yimengq/in-pipe-electronics-software/pcb/v0/PERIPH/PERIPH.xlsx

Component | Quantity | Unit Price | Total Price | Part Number (Digikey) | Notes | Link | Datasheet
TI DRV8234 Motor Driver | 3 | 4.06 | 12.18 | 296-DRV8234RTERTR-ND |  | https://www.digikey.com/en/products/detail/texas-instruments/DRV8234RTER/22147183 | https://www.ti.com/lit/ds/symlink/drv8234.pdf
MCP4725A0 DAC | 2 | 1.27 | 2.54 | MCP4725A0T-E/CHTR-ND |  | https://www.digikey.com/en/products/detail/microchip-technology/MCP4725A0T-E-CH/1818537 | https://ww1.microchip.com/downloads/aemDocuments/documents/MSLD/ProductDocuments/DataSheets/MCP4725-Data-Sheet-20002039E.pdf
MCP4725A1 DAC | 1 | 1.27 | 1.27 | MCP4725A1T-E/CHTR-ND | Specific MCP4725 part doesn't matter, as long as at least one of them has a different suffix (address reasons) | https://www.digikey.com/en/products/detail/microchip-technology/MCP4725A1T-E-CH/1827895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 | https://ww1.microchip.com/downloads/aemDocuments/documents/MSLD/ProductDocuments/DataSheets/MCP4725-Data-Sheet-20002039E.pdf
INA219 Current/Power Monitor | 1 | 2.9 | 2.9 | 296-27898-2-ND |  | https://www.digikey.com/en/products/detail/texas-instruments/INA219BIDCNT/2426056 | https://www.ti.com/lit/ds/symlink/ina219.pdf?ts=1766429459391
TI TPSM33625 Buck | 3 | 4.03 | 12.09 | 296-TPSM33625RDNRTR-ND | Estimated stock date (1-7) | https://www.digikey.com/en/products/detail/texas-instruments/TPSM33625RDNR/17395211 | https://www.ti.com/lit/ds/symlink/tpsm33625.pdf
JST SH 4 position 1 mm pitch connector | 2 | 3.95 | 7.9 | 1528-4208-ND | This might be a 10 pack (listed on Adafruit, but not sure) | https://www.digikey.com/en/products/detail/adafruit-industries-llc/4208/10230005 | https://cdn-shop.adafruit.com/product-files/4208/4208_Kaweei_C13396_diagram.pdf
