yimengq/in-pipe-electronics-software/pcb/v0/PERIPH/PERIPH.kicad_pcb

## KiCad design pcb/v0/PERIPH/PERIPH.kicad_pcb (2025-12-30)

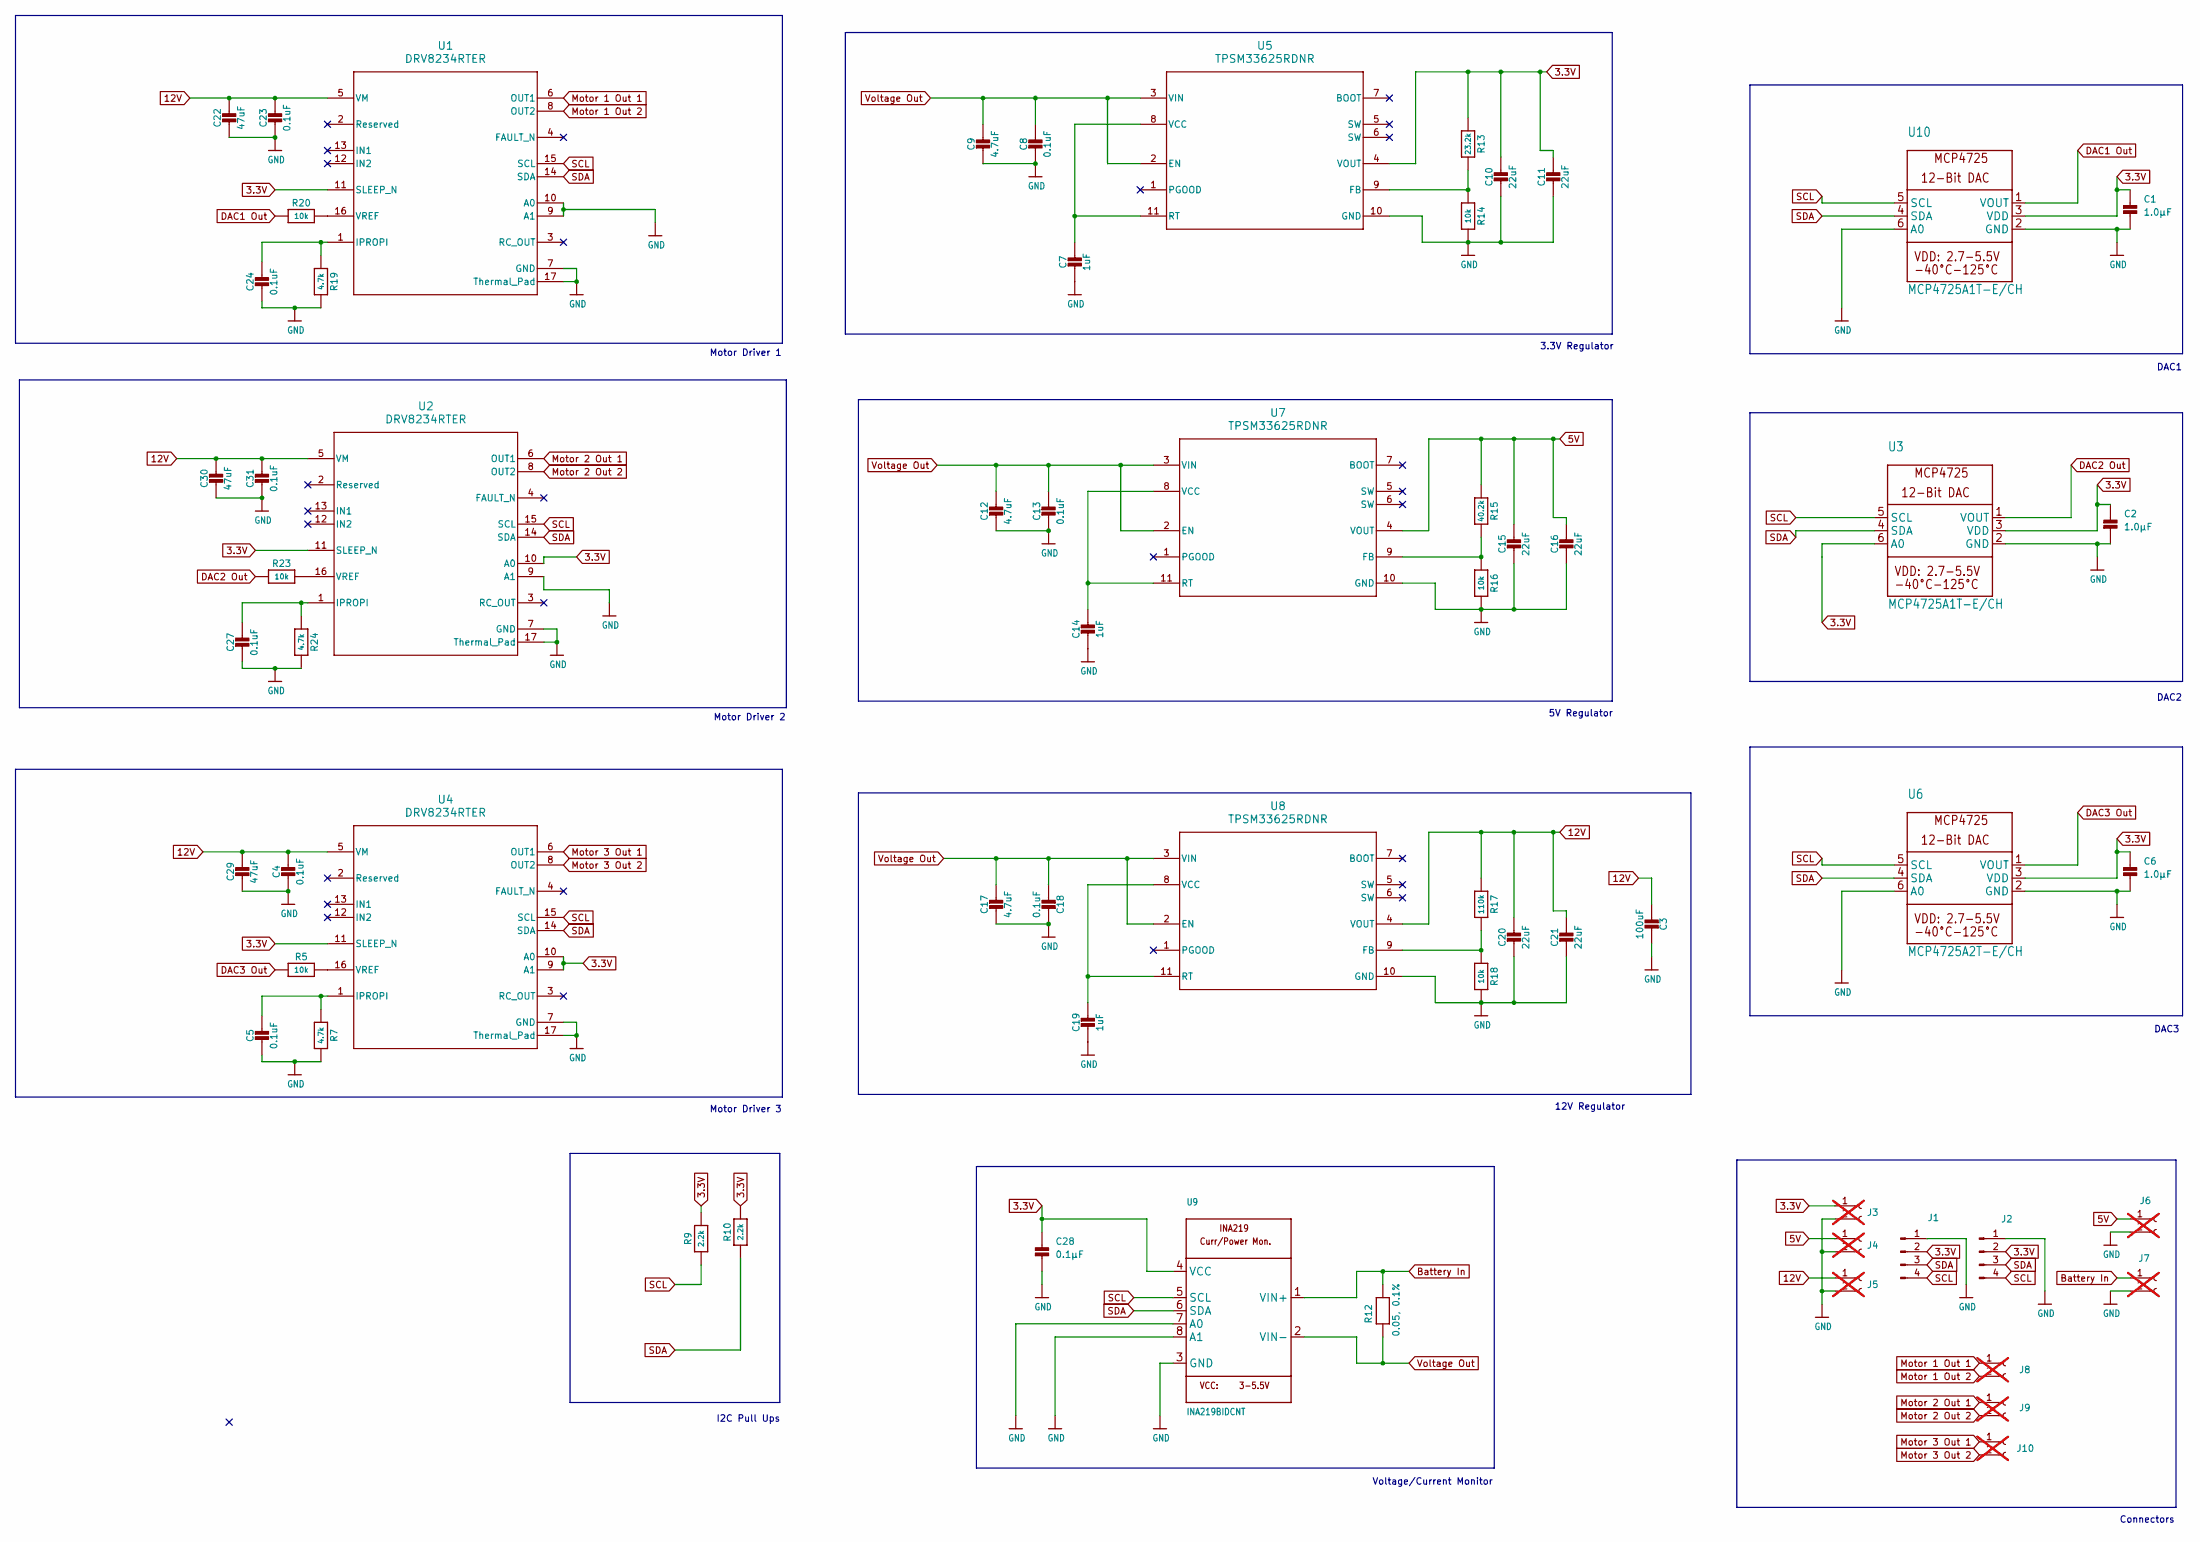
[picture p1: schematic PERIPH.kicad_sch]

Parts:
C1, C2, C6: 1.0µF; R_0603_1608Metric; MPN CL10B105KP8NNNC
C3: 100uF; PCAP_EEHZ_G_PAN-L; MPN EEH-ZA1H101P
C4, C5, C8, C13, C18, C23, C24, C27, C31: 0.1uF; R_0603_1608Metric; MPN C0603C104K3RACTU
C7, C14, C19: 1uF; R_0603_1608Metric; MPN CL10B105KP8NNNC
C9, C12, C17: 4.7uF; R_0805_2012Metric; MPN TMK212AB7475KG-T
C10, C11, C15, C16, C20, C21: 22uF; CAPC3225X270N; MPN CL32B226KAJNNNE
C22, C29, C30: 47uF; R_0603_1608Metric; MPN KTS250B476M76N0T00
C28: 0.1µF; R_0603_1608Metric; MPN C0603C104K3RACTU
J1, J2: JST SH 4 pin; CONN_SM04B-SRSS-TB_JST; MPN SM04B-SRSS-TB
J3, J4, J5, J6, J7, J8, J9, J10: Conn_01x02_Socket; PinSocket_1x02_P2.00mm_Vertical; not fitted
R5, R14, R16, R18, R20, R23: 10k; R_0603_1608Metric; MPN RC0603FR-0710KL
R7, R19, R24: 4.7k; R_0603_1608Metric; MPN CR0603-JW-472ELF
R9, R10: 2.2k; R_0603_1608Metric; MPN CR0603-FX-2201ELF
R12: 0.05, 0.1%; R_2512_6332Metric; MPN HoCG25122R050A4
R13: 23.2k; R_0603_1608Metric; MPN RC0603FR-0723K2L
R15: 40.2k; R_0603_1608Metric; MPN RC0603FR-0740K2L
R17: 110k; R_0603_1608Metric; MPN CRCW0603110KFKEAC
U1, U2, U4: DRV8234RTER; RTE0016C-IPC_A; MPN DRV8234RTER
U3, U10: MCP4725A1T-E/CH; SOT-23-6_MC_MCH; MPN MCP4725A1T-E/CH
U5, U7, U8: TPSM33625RDNR; RDN0011A-MFG; MPN TPSM33625RDNR
U6: MCP4725A2T-E/CH; SOT-23-6_MC_MCH; MPN MCP4725A2T-E/CH
U9: INA219BIDCNT; SOT65P280X145-8N; MPN INA219BIDCNT

Connections:
3.3V: C1.1, C2.1, C6.1, C10.1, C11.1, C28.1, J1.2, J2.2, J3.1, R9.2, R10.2, R13.1, U1.11 (SLEEP_N), U2.10 (A0), U2.11 (SLEEP_N), U3.3 (VDD), U3.6 (A0), U4.9 (A1), U4.10 (A0), U4.11 (SLEEP_N), U5.4 (VOUT), U6.3 (VDD), U9.4 (VCC), U10.3 (VDD)
5V: C15.1, C16.1, J4.1, J6.1, R15.1, U7.4 (VOUT)
12V: C3.1, C4.1, C20.1, C21.1, C22.1, C23.1, C29.1, C30.1, C31.1, J5.1, R17.1, U1.5 (VM), U2.5 (VM), U4.5 (VM), U8.4 (VOUT)
Battery In: J7.1, R12.2, U9.1 (VIN+)
DAC1 Out: R20.1, U10.1 (VOUT)
DAC2 Out: R23.1, U3.1 (VOUT)
DAC3 Out: R5.1, U6.1 (VOUT)
GND: C1.2, C2.2, C3.2, C4.2, C5.2, C6.2, C7.2, C8.2, C9.2, C10.2, C11.2, C12.2, C13.2, C14.2, C15.2, C16.2, C17.2, C18.2, C19.2, C20.2, C21.2, C22.2, C23.2, C24.2, C27.2, C28.2, C29.2, C30.2, C31.2, J1.1, J2.1, J3.2, J4.2, J5.2, J6.2, J7.2, R7.2, R14.2, R16.2, R18.2, R19.2, R24.2, U1.7 (GND), U1.9 (A1), U1.10 (A0), U1.17 (Thermal_Pad), U2.7 (GND), U2.9 (A1), U2.17 (Thermal_Pad), U3.2 (GND), U4.7 (GND), U4.17 (Thermal_Pad), U5.10 (GND), U6.2 (GND), U6.6 (A0), U7.10 (GND), U8.10 (GND), U9.3 (GND), U9.7 (A0), U9.8 (A1), U10.2 (GND), U10.6 (A0)
Motor 1 Out 1: J8.1, U1.6 (OUT1)
Motor 1 Out 2: J8.2, U1.8 (OUT2)
Motor 2 Out 1: J9.1, U2.6 (OUT1)
Motor 2 Out 2: J9.2, U2.8 (OUT2)
Motor 3 Out 1: J10.1, U4.6 (OUT1)
Motor 3 Out 2: J10.2, U4.8 (OUT2)
unnamed: C24.1, R19.1, U1.1 (IPROPI)
unnamed: R20.2, U1.16 (VREF)
unnamed: C27.1, R24.1, U2.1 (IPROPI)
unnamed: R23.2, U2.16 (VREF)
unnamed: C5.1, R7.1, U4.1 (IPROPI)
unnamed: R5.2, U4.16 (VREF)
unnamed: R13.2, R14.1, U5.9 (FB)
unnamed: C7.1, U5.8 (VCC), U5.11 (RT)
unnamed: R15.2, R16.1, U7.9 (FB)
unnamed: C14.1, U7.8 (VCC), U7.11 (RT)
unnamed: R17.2, R18.1, U8.9 (FB)
unnamed: C19.1, U8.8 (VCC), U8.11 (RT)
SCL: J1.4, J2.4, R9.1, U1.15 (SCL), U2.15 (SCL), U3.5 (SCL), U4.15 (SCL), U6.5 (SCL), U9.5 (SCL), U10.5 (SCL)
SDA: J1.3, J2.3, R10.1, U1.14 (SDA), U2.14 (SDA), U3.4 (SDA), U4.14 (SDA), U6.4 (SDA), U9.6 (SDA), U10.4 (SDA)
Voltage Out: C8.1, C9.1, C12.1, C13.1, C17.1, C18.1, R12.1, U5.2 (EN), U5.3 (VIN), U7.2 (EN), U7.3 (VIN), U8.2 (EN), U8.3 (VIN), U9.2 (VIN-)

Notes on the sheet:
Motor Driver 3
Motor Driver 2
I2C Pull Ups
DAC1
3.3V Regulator
Motor Driver 1
Voltage/Current Monitor
DAC2
Connectors
5V Regulator
12V Regulator
DAC3

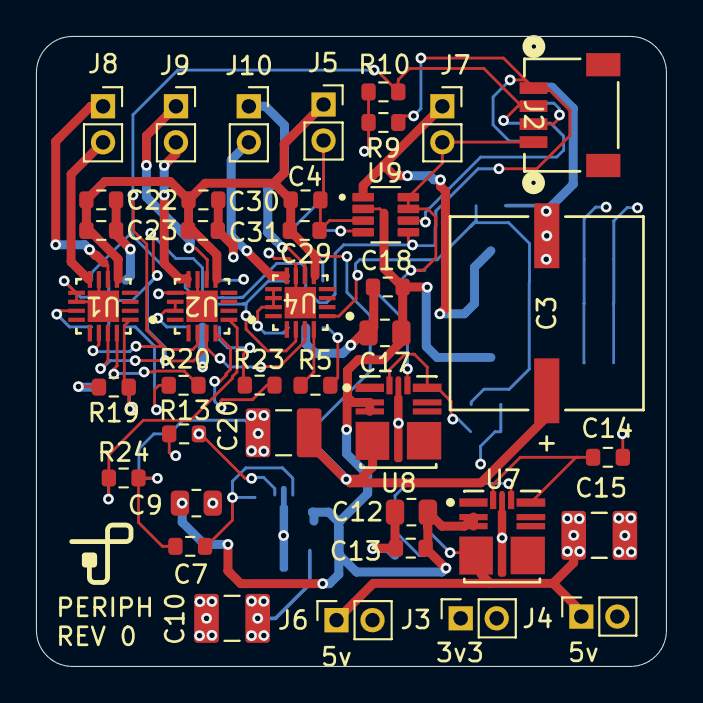
[picture p2: board PERIPH.kicad_pcb from above]

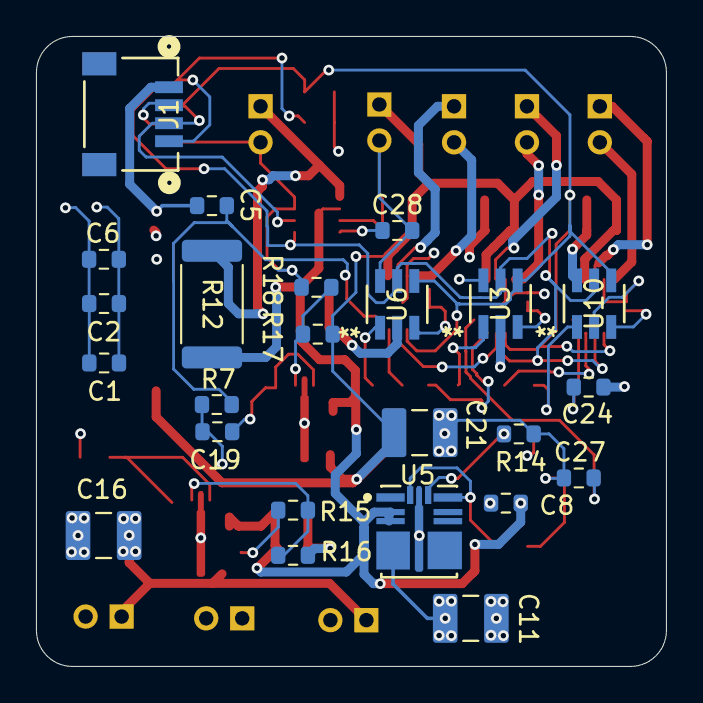
[picture p3: board PERIPH.kicad_pcb from below]

Board: 4 copper layers, 35.0 x 35.0 mm, 65 parts (24 on the bottom side), 29 nets.

Other parts of the board:
g: LOGO; logo
