yimengq/in-pipe-electronics-software/(commit log)

2025-12-21 Add gitignore for KiCad and local files
    [MotorDriverBreakout.kicad_pcb, MotorDriverBreakout.kicad_sch]
2025-12-29 Fixed minor addressing issues
    [MotorDriverBreakout.kicad_sch]
2025-12-29 Fixed merge issues
    [MotorDriverBreakout.kicad_sch]
2025-12-30 PERIPH REV0 - layout and schematic
    [MotorDriverBreakout.kicad_pcb, MotorDriverBreakout.kicad_sch, PERIPH.kicad_pcb, PERIPH.kicad_sch, PERIPH.xlsx]
2025-12-30 finish PERIPH V0
    [PERIPH.kicad_pcb, PERIPH.kicad_sch]
